yagizkorkmaz/esp32-c3-micro-quadcopter/hardware/drone.kicad_pcb

## KiCad design hardware/drone.kicad_pcb (2026-10-13)

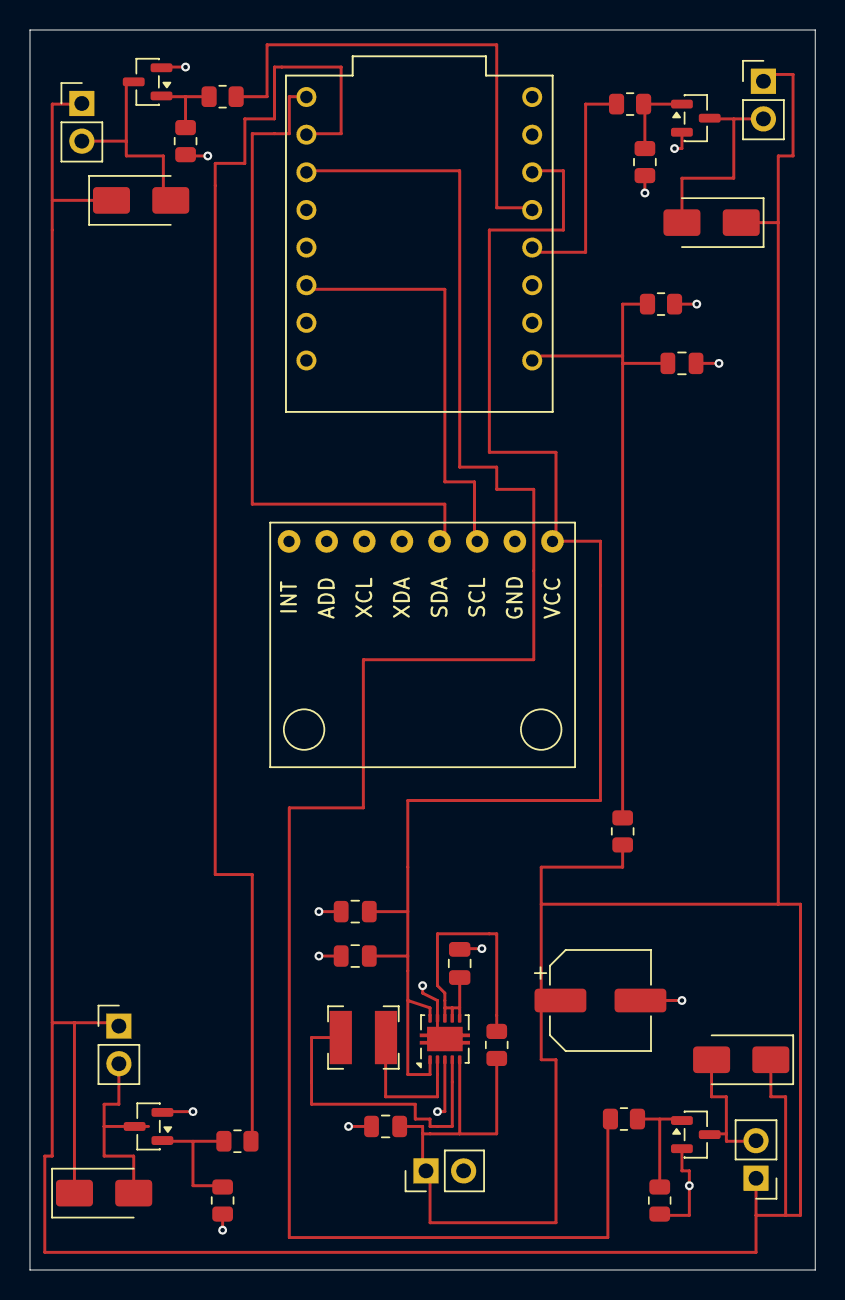
[picture p2: board drone.kicad_pcb from above]

Board: 2 copper layers, 53.0 x 83.7 mm, 34 parts (0 on the bottom side), 21 nets, no tracks yet.

Parts:
C1, C2, C3: 10u; C_0805_2012Metric
C4, C6: 100n; C_0805_2012Metric
C5: 220u; CP_Elec_6.3x5.8
D1, D2, D3, D4: SS34; D_SMA
L1: 2.2u; L_Bourns-SRN4018
Q1, Q2, Q3, Q4: AO3400A; SOT-23
R1, R3, R5, R7, R9: 100; R_0805_2012Metric
R2, R4, R6, R8: 10k; R_0805_2012Metric
R10, R11: 47k; R_0805_2012Metric
U1: ESP32_C3_Super_Mini; MODULE_ESP32-C3_SUPERMINI_TH
U2: TPS63001; Texas_DRC0010J
U3: module_mpu6050
batarya1: Conn_01x02; PinHeader_1x02_P2.54mm_Vertical
motor1, motor2, motor3, motor4: Conn_01x02; PinHeader_1x02_P2.54mm_Vertical

Connections:
GND: C1.1, C2.2, C3.2, C4.1, C5.2, C6.2, Q1.2 (S), Q2.2 (S), Q3.2 (S), Q4.2 (S), R2.2, R4.2, R6.2, R8.2, R11.2, U2.3 (PGND), U2.9 (GND), U2.11 (PGND), U3.2 (GND), U3.7 (ADD), batarya1.2
unnamed: D1.2 (A), Q1.3 (D), motor1.2
unnamed: C1.2, C5.1, D1.1 (K), D2.1 (K), D3.1 (K), D4.1 (K), R9.1, R10.1, U2.5 (VIN), batarya1.1, motor1.1, motor2.1, motor3.1, motor4.1
unnamed: D2.2 (A), Q2.3 (D), motor2.2
unnamed: D3.2 (A), Q3.3 (D), motor3.2
unnamed: D4.2 (A), Q4.3 (D), motor4.2
unnamed: Q1.1 (G), R1.2, R2.1
unnamed: Q2.1 (G), R3.2, R4.1
unnamed: Q3.1 (G), R5.2, R6.1
unnamed: Q4.1 (G), R7.2, R8.1
unnamed: C2.1, C3.1, U1.3.3, U2.1 (VOUT), U2.10 (FB), U3.1 (VCC)
unnamed: C6.1, R10.2, R11.1, U1.0 (GPIO0)
unnamed: R1.1, U1.3 (GPIO3)
unnamed: R3.1, U1.4 (GPIO4)
unnamed: U1.5 (GPIO5), U3.4 (SDA)
unnamed: R5.1, U1.6 (GPIO6)
unnamed: R7.1, U1.7 (GPIO7)
unnamed: U1.10 (GPIO10), U3.3 (SCL)
unnamed: C4.2, R9.2, U2.6 (EN), U2.7 (PS/SYNC), U2.8 (VINA)
unnamed: L1.1, U2.4 (L1)
unnamed: L1.2, U2.2 (L2)
